sdp8483/DigiMatex_DS410_repair/pcb/schematic_pdf/digiMatex_DS410.pdf

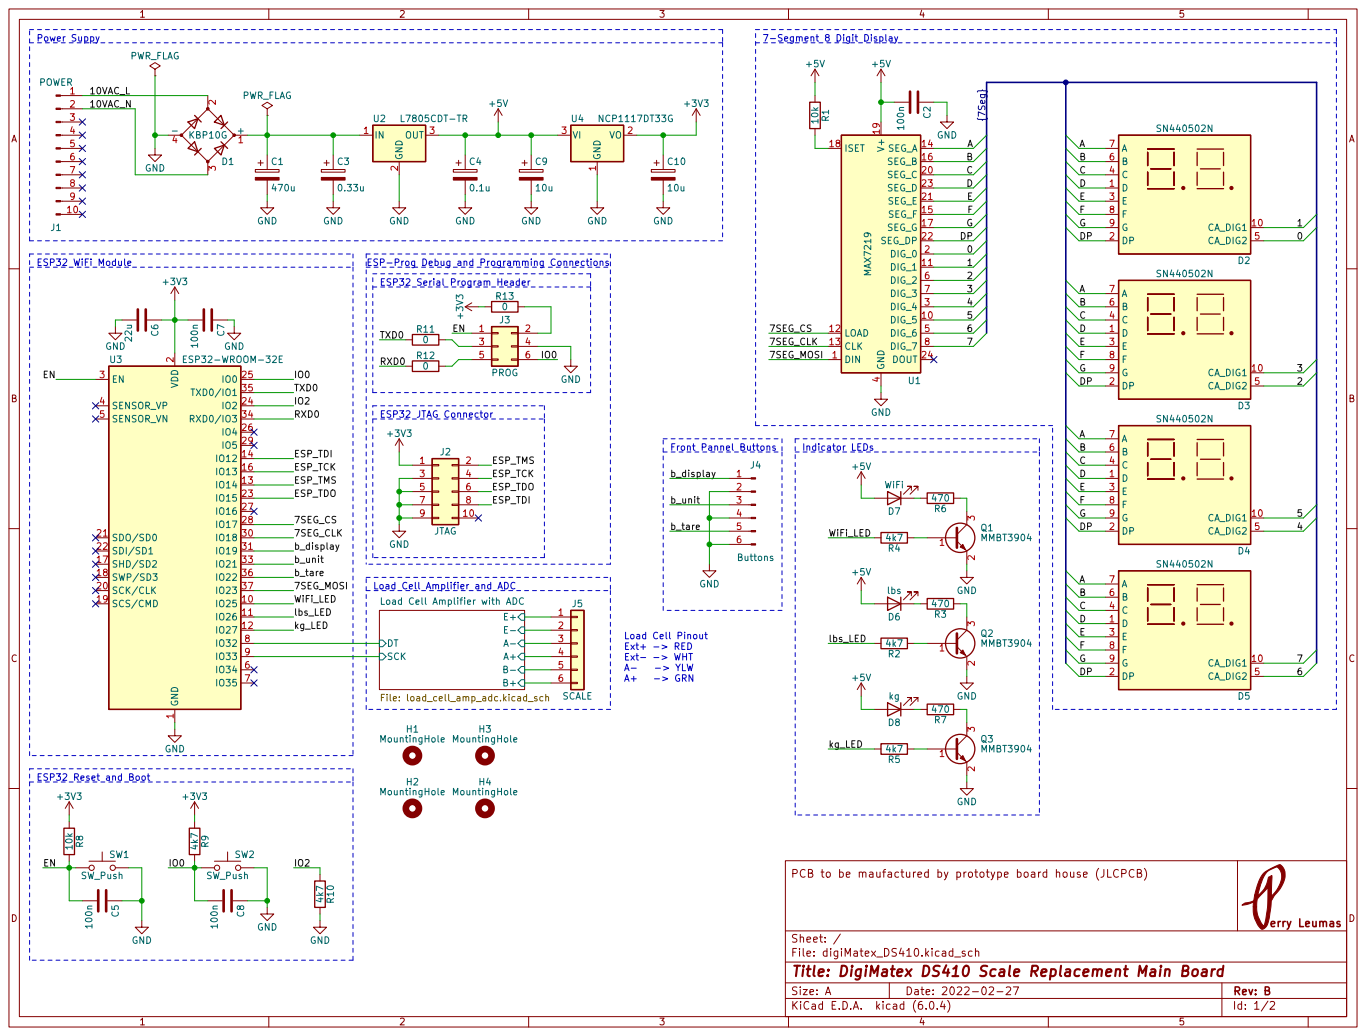
[picture p1: page 1]

Indicator LEDs ESP-Prog Debug and Programming Connections
ESP32 Serial Program Header

2 SCK/CLK 20 SDO/SD0 21 SDI/SD1 22

Load Cell Amplifier and ADC

Load Cell Pinout Ext+ -> RED

Id: 1/2 Title: DigiMatex DS410 Scale Replacement Main Board

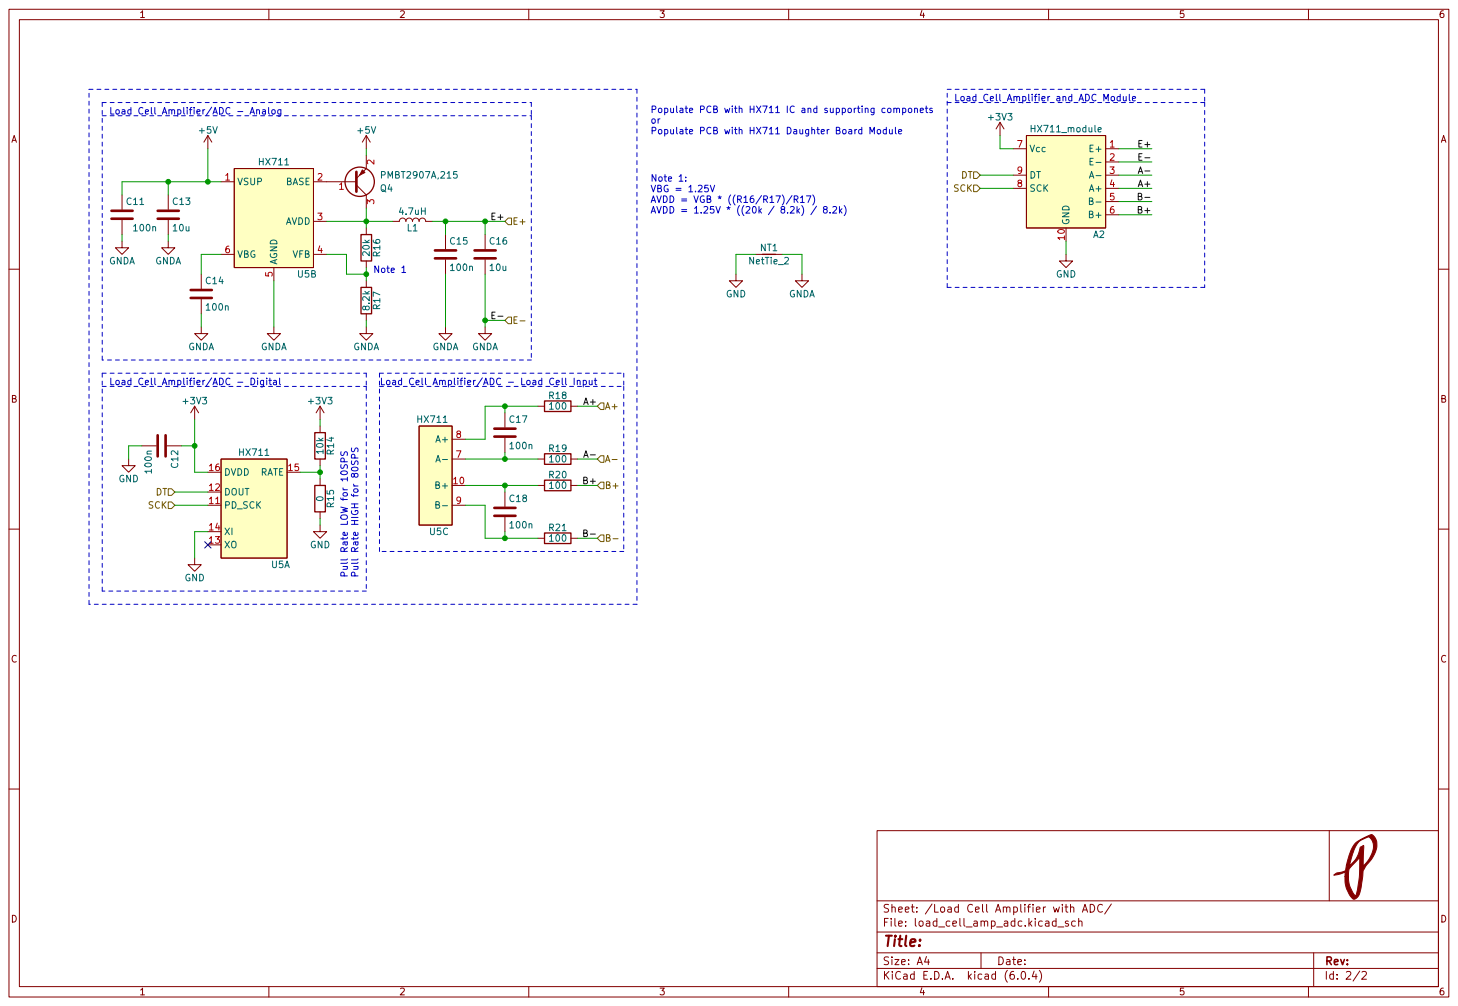
[picture p2: page 2]

Load Cell Amplifier and ADC Module

Load Cell Amplifier/ADC - Analog

Populate PCB with HX711 IC and supporting componets or Populate PCB with HX711 Daughter Board Module Note 1: VBG = 1.25V

2 3 Q4PMBT2907A,215 VSUP 1 BASE 2 AVDD 3 VFB 4 AGND

Load Cell Amplifier/ADC - Digital

Sheet: /Load Cell Amplifier with ADC/
File: load_cell_amp_adc.kicad_sch
Id: 2/2 Title:
