sdp8483/DigiMatex_DS410_repair/pcb/digiMatex_DS410.kicad_pcb

## KiCad design pcb/digiMatex_DS410.kicad_pcb (2022-03-26)

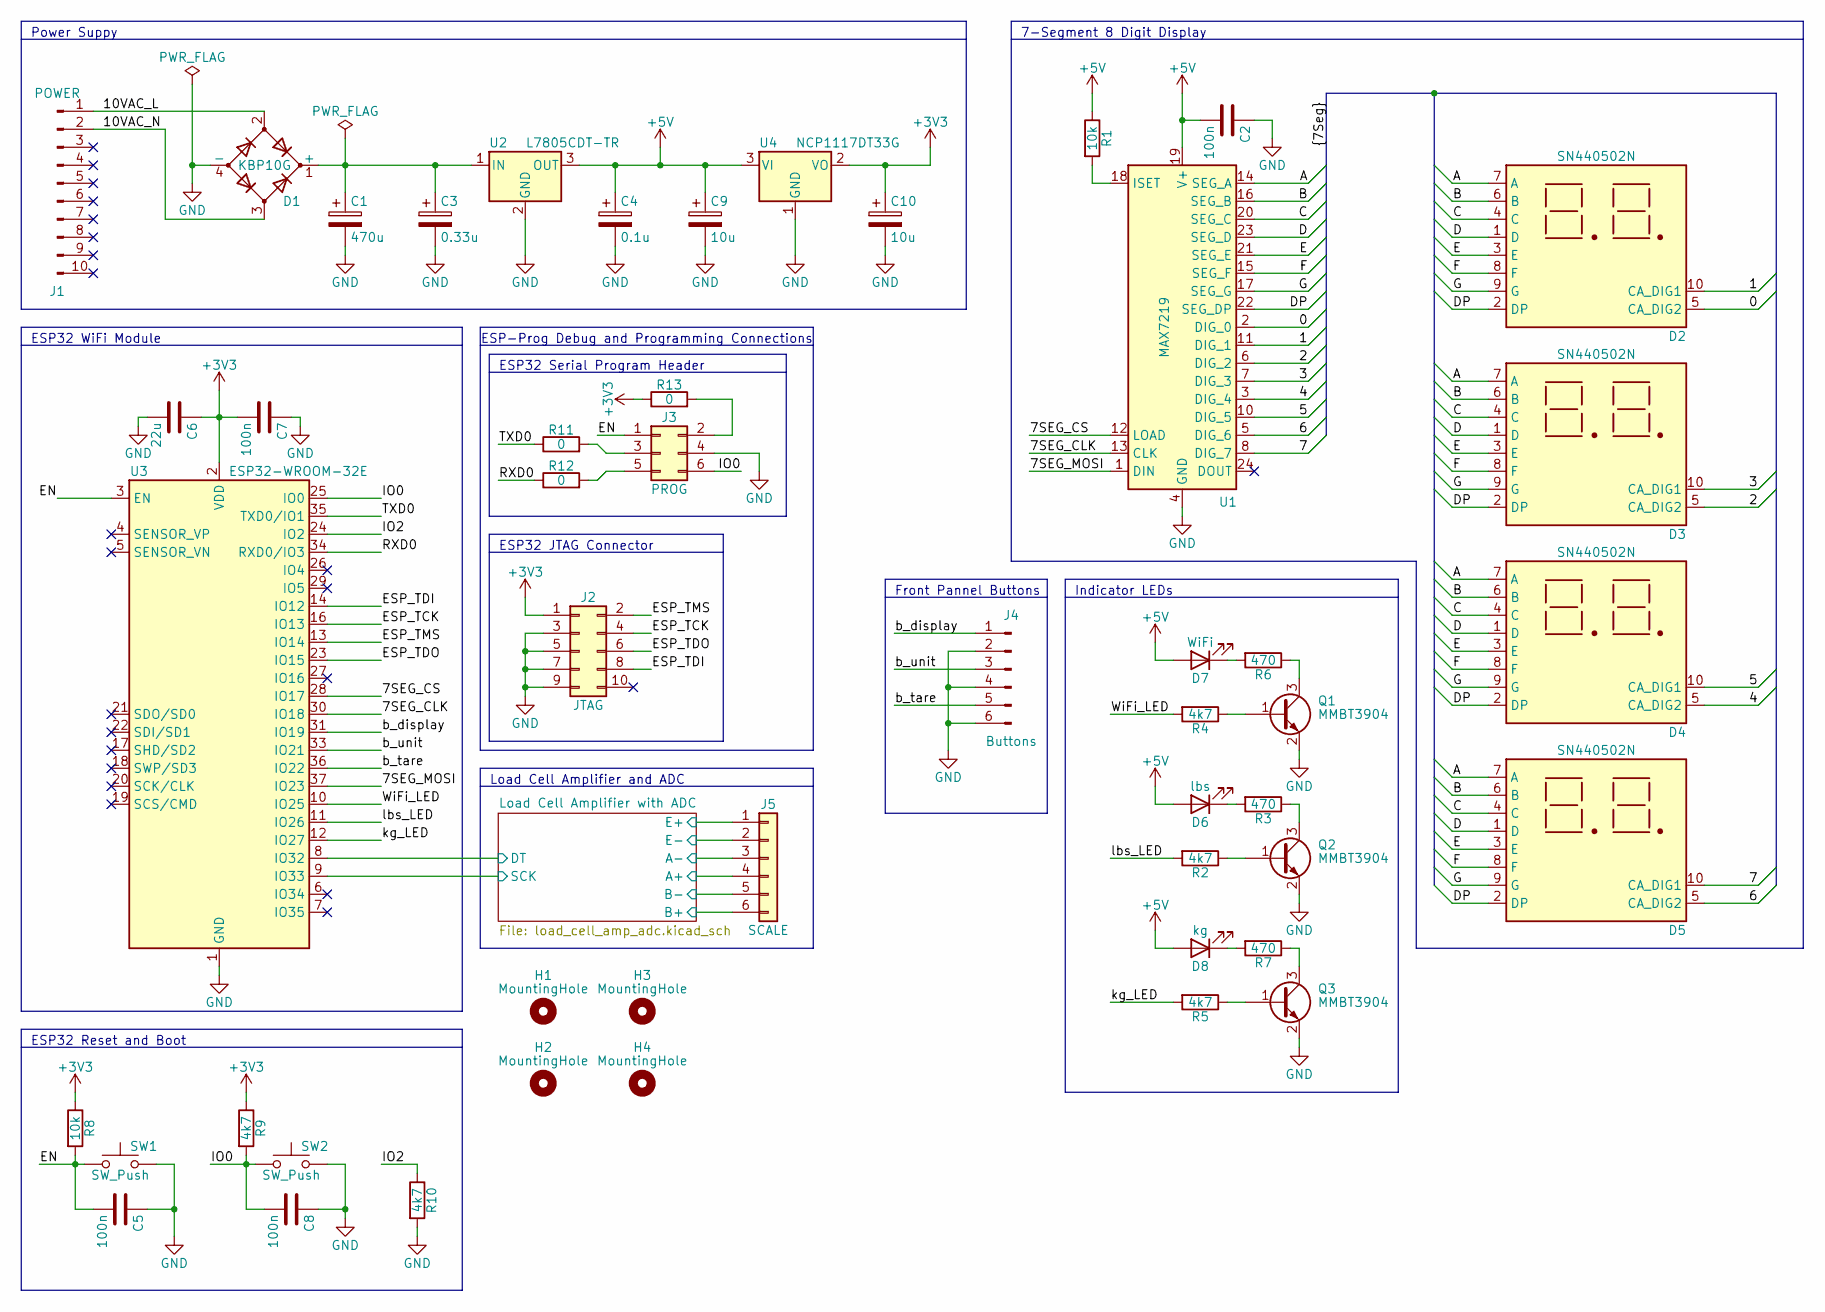
[picture p3: schematic digiMatex_DS410.kicad_sch, DigiMatex DS410 Scale Replacement Main Board]

Parts:
C1: 470u; CP_Radial_D10.0mm_P5.00mm
C2, C5, C7, C8: 100n; C_0603_1608Metric
C3: 0.33u; CP_Radial_D6.3mm_P2.50mm
C4: 0.1u; CP_Radial_D6.3mm_P2.50mm
C6: 22u; C_1206_3216Metric
C9, C10: 10u; CP_Radial_D6.3mm_P2.50mm
D1: KBP10G; Diode_Bridge_Vishay_KBPM
D2, D3, D4, D5: SN440502N
D6: lbs; LED_D5.0mm
D7: WiFi; LED_D5.0mm
D8: kg; LED_D5.0mm
H1, H2, H3, H4: MountingHole; MountingHole_4mm_Pad
J1: POWER; Molex_KK-254_AE-6410-10A_1x10_P2.54mm_Vertical
J2: JTAG; PinHeader_2x05_P2.54mm_Vertical
J3: PROG; PinHeader_2x03_P2.54mm_Vertical
J4: Buttons; Molex_KK-254_AE-6410-06A_1x06_P2.54mm_Vertical
J5: SCALE; TerminalBlock_Phoenix_MKDS-1,5-6_1x06_P5.00mm_Horizontal
Q1, Q2, Q3: MMBT3904; SOT-23
R1, R8: 10k; R_0603_1608Metric_Pad0.98x0.95mm_HandSolder
R2, R4, R5, R9, R10: 4k7; R_0603_1608Metric_Pad0.98x0.95mm_HandSolder
R3, R6, R7: 470; R_Axial_DIN0207_L6.3mm_D2.5mm_P10.16mm_Horizontal
R11, R12, R13: 0; R_0805_2012Metric_Pad1.20x1.40mm_HandSolder
SW1, SW2: SW_Push; SW_PUSH_6mm
U1: MAX7219; SOIC-24W_7.5x15.4mm_P1.27mm
U2: L7805CDT-TR; TO-252-2
U3: ESP32-WROOM-32E; ESP32-WROOM-32
U4: NCP1117DT33G; TO-252-2

Connections:
+3V3: C6.1, C7.2, C10.1, J2.1, R8.1, R9.1, R13.1, U3.2 (VDD), U4.2 (VO); also elsewhere on the board
+5V: C2.2, C4.1, C9.1, D6.2 (A), D7.2 (A), D8.2 (A), R1.1, U1.19 (V+), U2.3 (OUT), U4.3 (VI); also elsewhere on the board
/0: D2.5 (CA_DIG2), U1.2 (DIG_0)
/1: D2.10 (CA_DIG1), U1.11 (DIG_1)
/2: D3.5 (CA_DIG2), U1.6 (DIG_2)
/3: D3.10 (CA_DIG1), U1.7 (DIG_3)
/4: D4.5 (CA_DIG2), U1.3 (DIG_4)
/5: D4.10 (CA_DIG1), U1.10 (DIG_5)
/6: D5.5 (CA_DIG2), U1.5 (DIG_6)
/7: D5.10 (CA_DIG1), U1.8 (DIG_7)
/7SEG_CLK: U1.13 (CLK), U3.30 (IO18)
/7SEG_CS: U1.12 (LOAD), U3.28 (IO17)
/7SEG_MOSI: U1.1 (DIN), U3.37 (IO23)
/10VAC_L: D1.2, J1.1
/10VAC_N: D1.3, J1.2
/A: D2.7 (A), D3.7 (A), D4.7 (A), D5.7 (A), U1.14 (SEG_A)
/B: D2.6 (B), D3.6 (B), D4.6 (B), D5.6 (B), U1.16 (SEG_B)
/C: D2.4 (C), D3.4 (C), D4.4 (C), D5.4 (C), U1.20 (SEG_C)
/D: D2.1 (D), D3.1 (D), D4.1 (D), D5.1 (D), U1.23 (SEG_D)
/DP: D2.2 (DP), D3.2 (DP), D4.2 (DP), D5.2 (DP), U1.22 (SEG_DP)
/E: D2.3 (E), D3.3 (E), D4.3 (E), D5.3 (E), U1.21 (SEG_E)
/EN: C5.2, J3.1, R8.2, SW1.1, U3.3 (EN)
/ESP_TCK: J2.4, U3.16 (IO13)
/ESP_TDI: J2.8, U3.14 (IO12)
/ESP_TDO: J2.6, U3.23 (IO15)
/ESP_TMS: J2.2, U3.13 (IO14)
/F: D2.8 (F), D3.8 (F), D4.8 (F), D5.8 (F), U1.15 (SEG_F)
/G: D2.9 (G), D3.9 (G), D4.9 (G), D5.9 (G), U1.17 (SEG_G)
/IO0: C8.2, J3.6, R9.2, SW2.1, U3.25 (IO0)
/IO2: R10.1, U3.24 (IO2)
/Load Cell Amplifier with ADC/A+: J5.4; also elsewhere on the board
/Load Cell Amplifier with ADC/A-: J5.3; also elsewhere on the board
/Load Cell Amplifier with ADC/B+: J5.6; also elsewhere on the board
/Load Cell Amplifier with ADC/B-: J5.5; also elsewhere on the board
/Load Cell Amplifier with ADC/DT: U3.8 (IO32); also elsewhere on the board
/Load Cell Amplifier with ADC/E+: J5.1; also elsewhere on the board
/Load Cell Amplifier with ADC/SCK: U3.9 (IO33); also elsewhere on the board
/RXD0: R12.1, U3.34 (RXD0/IO3)
/TXD0: R11.1, U3.35 (TXD0/IO1)
/WiFi_LED: R4.2, U3.10 (IO25)
/b_display: J4.1, U3.31 (IO19)
/b_tare: J4.5, U3.36 (IO22)
/b_unit: J4.3, U3.33 (IO21)
/kg_LED: R5.2, U3.12 (IO27)
/lbs_LED: R2.2, U3.11 (IO26)
GND: C1.2, C2.1, C3.2, C4.2, C5.1, C6.2, C7.1, C8.1, C9.2, C10.2, D1.4 (-), J2.3, J2.5, J2.7, J2.9, J3.4, J4.2, J4.4, J4.6, Q1.2 (E), Q2.2 (E), Q3.2 (E), R10.2, SW1.2, SW2.2, U1.4 (GND), U1.9 (GND), U2.2 (GND), U3.1 (GND), U3.15 (GND), U3.38 (GND), U3.39 (GND), U4.1 (GND); also elsewhere on the board
GNDA: J5.2; also elsewhere on the board
unnamed: C1.1, C3.1, D1.1 (+), U2.1 (IN)
unnamed: D6.1 (K), R3.2
unnamed: D7.1 (K), R6.2
unnamed: D8.1 (K), R7.2
unnamed: J3.2, R13.2
unnamed: J3.3, R11.2
unnamed: J3.5, R12.2
unnamed: Q1.1 (B), R4.1
unnamed: Q1.3 (C), R6.1
unnamed: Q2.1 (B), R2.1
unnamed: Q2.3 (C), R3.1
unnamed: Q3.1 (B), R5.1
unnamed: Q3.3 (C), R7.1
unnamed: R1.2, U1.18 (ISET)

Notes on the sheet:
Front Pannel Buttons
ESP32 Reset and Boot
Power Suppy
7-Segment 8 Digit Display
Load Cell Amplifier and ADC
Indicator LEDs
ESP-Prog Debug and Programming Connections
ESP32 JTAG Connector
ESP32 Serial Program Header
ESP32 WiFi Module

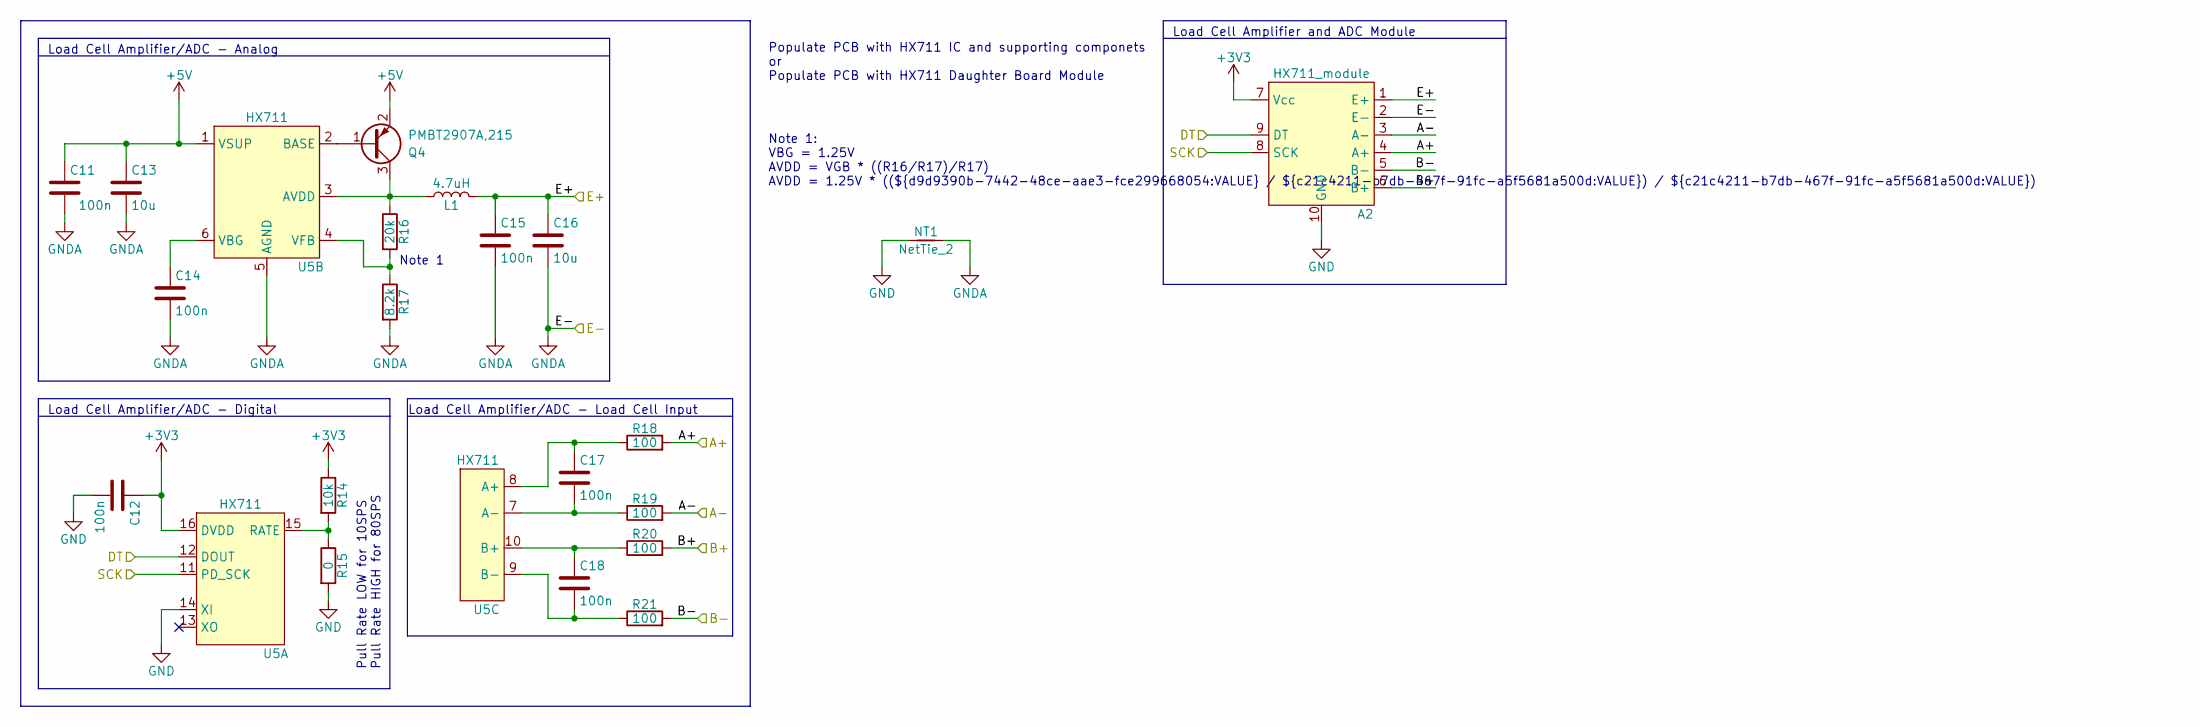
[picture p4: schematic load_cell_amp_adc.kicad_sch]

Parts:
A2: HX711_module
C11, C12, C14, C15, C17, C18: 100n; C_0603_1608Metric
C13, C16: 10u; C_0805_2012Metric_Pad1.18x1.45mm_HandSolder
L1: 4.7uH; L_0805_2012Metric_Pad1.05x1.20mm_HandSolder
NT1: NetTie_2; NetTie-2_SMD_Pad2.0mm
Q4: PMBT2907A,215; SOT-23
R14: 10k; R_0603_1608Metric_Pad0.98x0.95mm_HandSolder
R15: 0; R_0603_1608Metric_Pad0.98x0.95mm_HandSolder
R16: 20k; R_0805_2012Metric_Pad1.20x1.40mm_HandSolder
R17: 8.2k; R_0805_2012Metric_Pad1.20x1.40mm_HandSolder
R18, R19, R20, R21: 100; R_0603_1608Metric_Pad0.98x0.95mm_HandSolder
U5: HX711; SOP-16_3.9x9.9mm_P1.27mm

Connections:
+3V3: A2.7 (Vcc), C12.1, R14.1, U5.16 (DVDD); also elsewhere on the board
+5V: C11.1, C13.1, Q4.2 (E), U5.1 (VSUP); also elsewhere on the board
/Load Cell Amplifier with ADC/A+: A2.4 (A+), R18.2; also elsewhere on the board
/Load Cell Amplifier with ADC/A-: A2.3 (A-), R19.2; also elsewhere on the board
/Load Cell Amplifier with ADC/B+: A2.6 (B+), R20.2; also elsewhere on the board
/Load Cell Amplifier with ADC/B-: A2.5 (B-), R21.2; also elsewhere on the board
/Load Cell Amplifier with ADC/DT: A2.9 (DT), U5.12 (DOUT); also elsewhere on the board
/Load Cell Amplifier with ADC/E+: A2.1 (E+), C15.1, C16.1, L1.1; also elsewhere on the board
/Load Cell Amplifier with ADC/SCK: A2.8 (SCK), U5.11 (PD_SCK); also elsewhere on the board
GND: A2.10 (GND), C12.2, NT1.1, R15.2, U5.14 (XI); also elsewhere on the board
GNDA: A2.2 (E-), C11.2, C13.2, C14.2, C15.2, C16.2, NT1.2, R17.2, U5.5 (AGND); also elsewhere on the board
unnamed: C14.1, U5.6 (VBG)
unnamed: C17.1, R18.1, U5.8 (A+)
unnamed: C17.2, R19.1, U5.7 (A-)
unnamed: C18.1, R20.1, U5.10 (B+)
unnamed: C18.2, R21.1, U5.9 (B-)
unnamed: L1.2, Q4.3 (C), R16.1, U5.3 (AVDD)
unnamed: Q4.1 (B), U5.2 (BASE)
unnamed: R14.2, R15.1, U5.15 (RATE)
unnamed: R16.2, R17.1, U5.4 (VFB)

Notes on the sheet:
Note 1: VBG = 1.25V AVDD = VGB * ((R16/R17)/R17) AVDD = 1.25V * ((${d9d9390b-7442-48ce-aae3-fce299668054:VALUE} / ${c21c4211-b7db-467f-91fc-a5f5681a500d:VALUE}) / ${c21c4211-b7db-467f-91fc-a5f5681a500d:VALUE})
Pull Rate LOW for 10SPS Pull Rate HIGH for 80SPS
Populate PCB with HX711 IC and supporting componets or Populate PCB with HX711 Daughter Board Module
Load Cell Amplifier/ADC - Analog
Load Cell Amplifier/ADC - Load Cell Input
Load Cell Amplifier and ADC Module
Load Cell Amplifier/ADC - Digital
Note 1

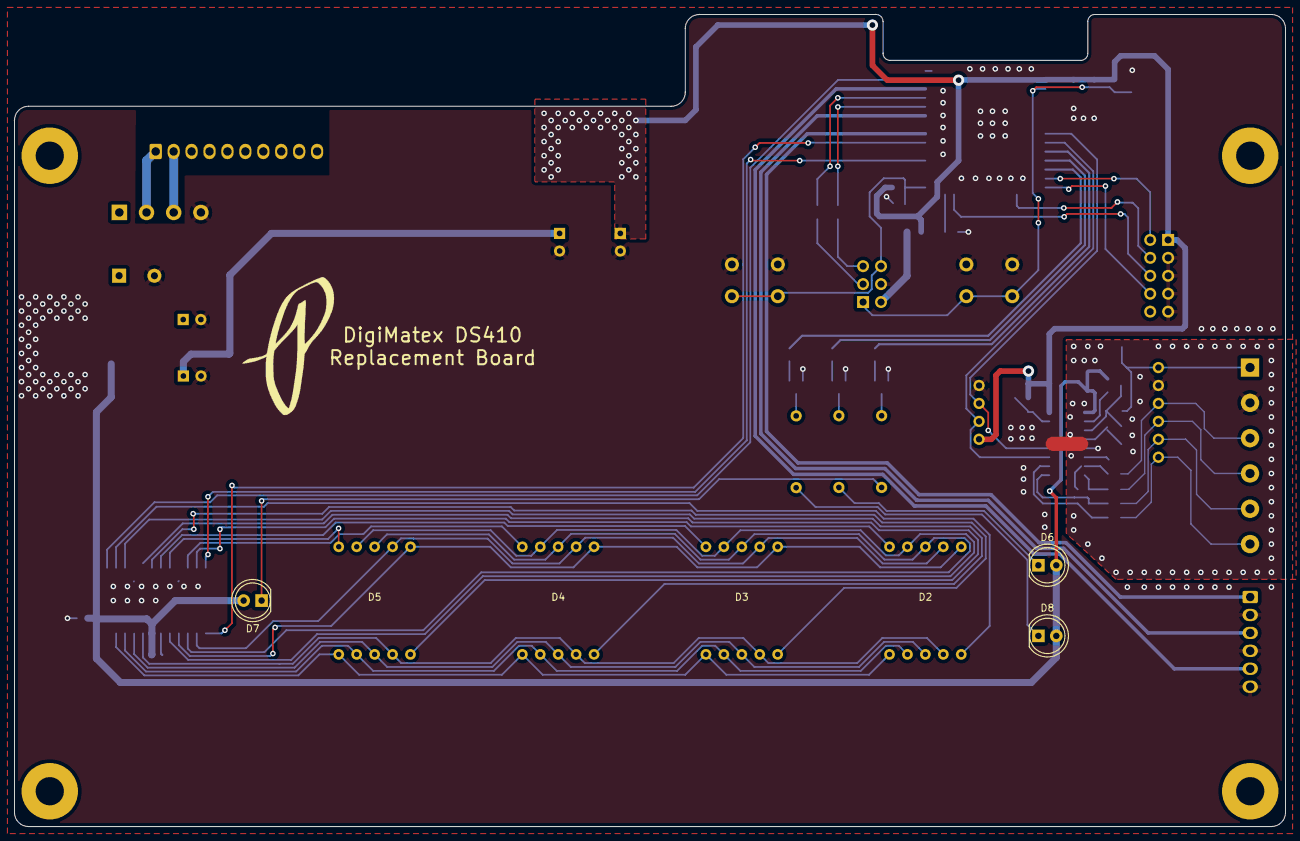
[picture p5: board digiMatex_DS410.kicad_pcb from above]

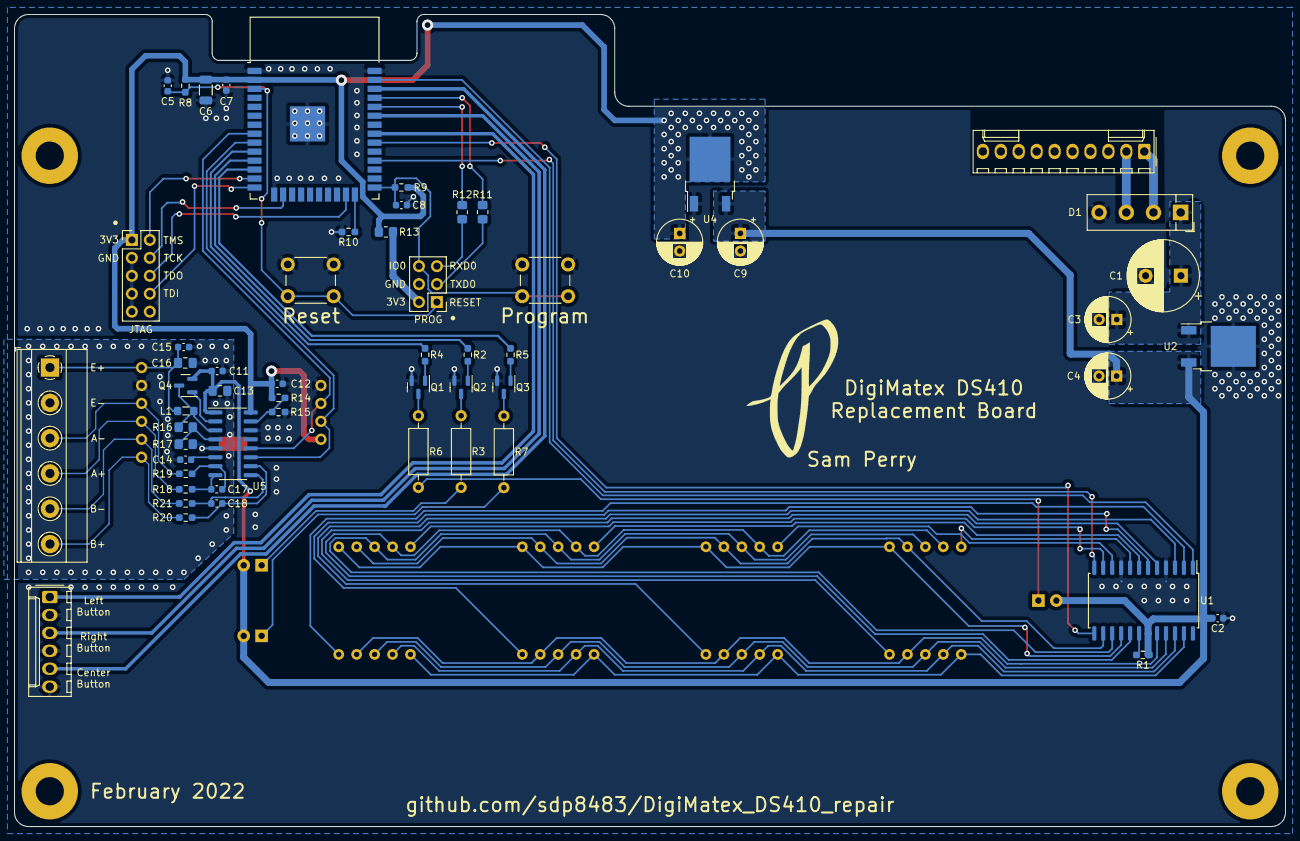
[picture p6: board digiMatex_DS410.kicad_pcb from below]

Board: 2 copper layers, 180.0 x 115.0 mm, 70 parts (58 on the bottom side), 70 nets.
