sdp8483/DigiMatex_DS410_repair/(commit log)

2022-01-25 remove old files
    [digiMatex_DS410.kicad_pcb, digiMatex_DS410.sch]
2022-01-30 remove stm32 fw
2022-01-30 init schematic
    [digiMatex_DS410.kicad_sch]
2022-01-30 add mounts, buttons, and LEDs
    [digiMatex_DS410.kicad_sch]
2022-01-30 start pcb layout
    [digiMatex_DS410.kicad_pcb]
2022-02-04 replace mini-360 with 7805 regulator
    [digiMatex_DS410.kicad_sch]
2022-02-05 add esp32 model
2022-02-06 export pdf
    [digiMatex_DS410.kicad_sch]
2022-02-06 final pcb layout
    [digiMatex_DS410.kicad_pcb]
2022-02-06 export gerber
    [digiMatex_DS410.kicad_pcb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]
2022-02-07 generate gcode
    [0.8mm.drl, 0.9mm.drl, 1.0mm.drl, 1.1mm.drl, 1.2mm.drl, 1.8mm.drl, 4.0mm.drl]
2022-02-21 rev A schematic with more SMD
    [0.8mm.drl, 0.9mm.drl, 1.0mm.drl, 1.1mm.drl, 1.2mm.drl, 1.8mm.drl, 4.0mm.drl, digiMatex_DS410-B_Cu.gbr]
2022-02-25 start pcb layout rev A
    [digiMatex_DS410.kicad_pcb]
2022-02-26 use resistor footprints
    [digiMatex_DS410.kicad_sch]
2022-02-26 rev A layout
    [digiMatex_DS410.kicad_pcb, digiMatex_DS410.kicad_sch]
2022-02-27 revA gerbers
    [digiMatex_DS410-B_Cu.gbr, digiMatex_DS410-B_Mask.gbr, digiMatex_DS410-B_Paste.gbr, digiMatex_DS410-B_Silkscreen.gbr, digiMatex_DS410-Edge_Cuts.gbr, digiMatex_DS410-F_Cu.gbr, digiMatex_DS410-F_Mask.gbr, digiMatex_DS410-F_Paste.gbr]
2022-02-27 add HX711 IC to main board
    [digiMatex_DS410.kicad_sch, load_cell_amp_adc.kicad_sch]
2022-02-27 rev b layout
    [digiMatex_DS410.kicad_pcb, digiMatex_DS410.kicad_sch, load_cell_amp_adc.kicad_sch]
2022-02-27 rev b gerber
    [digiMatex_DS410-B_Cu.gbr, digiMatex_DS410-B_Mask.gbr, digiMatex_DS410-B_Paste.gbr, digiMatex_DS410-B_Silkscreen.gbr, digiMatex_DS410-Edge_Cuts.gbr, digiMatex_DS410-F_Cu.gbr, digiMatex_DS410-F_Mask.gbr, digiMatex_DS410-F_Paste.gbr]
2022-03-26 generate revB ibom
    [digiMatex_DS410.kicad_pcb]
2022-03-27 add load cell pinout
    [digiMatex_DS410.kicad_sch, load_cell_amp_adc.kicad_sch]
2022-03-29 implement wifi led
2022-04-09 fix unit button
